headedspy/Telescope/README.md

# Telescope



An ESP8266 Project of a 3D printed telescope prototype that can find and aim towards objects in the night sky.



[**[VIDEO DEMO]**](https://www.youtube.com/watch?v=OSxU1J9f-Es)
